boinger/sauna-controller-esp32/README.md

# Sauna Controller - ESP32 Firmware

Open-source ESP32 firmware for controlling an electric sauna heater with native Apple HomeKit integration and a REST API for the companion iOS app.

## Features

- **HomeKit Native**: Appears as a Thermostat in Apple Home app — control via Siri or Home app
- **REST API**: HTTP endpoints for the companion iOS app (port 8080)
- **Temperature Monitoring**: Real-time temperature from DS18B20 sensor
- **Safety First**: Hard temperature limits, session timeouts, fail-safe defaults
- **Local Only**: No cloud, no accounts, no subscriptions — just your local WiFi

## Hardware Requirements

- ESP32 development board (ESP32-WROOM-32 or similar)
- DS18B20 temperature sensor (waterproof version recommended for sauna environment)
- Relay module (5V, appropriate for your contactor coil)
- Contactor rated for your heater (7kW @ 240V = ~30A)

### Wiring

```
ESP32 GPIO 26 ──► Relay IN ──► Contactor Coil
ESP32 GPIO 27 ──► DS18B20 Data (with 4.7kΩ pullup to 3.3V)
ESP32 GPIO 2  ──► Status LED (onboard)
ESP32 3.3V    ──► DS18B20 VCC
ESP32 GND     ──► DS18B20 GND, Relay GND
```

⚠️ **WARNING**: This project controls high-voltage equipment. Ensure all electrical work is done by a qualified electrician and meets local codes.

See the `hardware/` subdirectory for detailed component specs and a KiCad schematic.

## Building

Requires [PlatformIO](https://platformio.org/).

```bash
# Clone the repo
git clone https://github.com/boinger/sauna-controller-esp32.git
cd sauna-controller-esp32

# Build
pio run

# Flash to ESP32
pio run --target upload

# Monitor serial output
pio device monitor
```

## OTA Updates

After the initial USB flash, firmware can be updated over WiFi (OTA):

```bash
pio run --target upload --upload-port <ESP32_IP>
```

You'll be prompted for the OTA password (set in `include/secrets.h`).

**First-time setup:**
1. Copy `include/secrets.h.example` to `include/secrets.h`
2. Set your OTA password in `secrets.h`
3. Flash via USB: `pio run --target upload`
4. All subsequent updates can use OTA

The OTA password can also be changed at runtime via the HomeSpan serial CLI (`O` command).

## HomeKit Setup

1. Power on the ESP32
2. Open the Home app on your iPhone
3. Tap "+" → "Add Accessory"
4. The ESP32 will broadcast as "Sauna Controller"
5. Follow pairing prompts (default setup code shown in serial monitor)

## WiFi Configuration

The firmware uses HomeSpan's built-in WiFi provisioning. On first boot (or if the stored network is unavailable), you can configure WiFi via:

- **Serial CLI**: Connect via `pio device monitor` and press `W` to start the WiFi setup wizard
- **AP Mode**: The ESP32 creates a temporary access point — connect to it and follow the captive portal prompts

WiFi credentials are stored in the ESP32's non-volatile storage and persist across reboots.

## REST API

The firmware runs an HTTP server on **port 8080** (HomeSpan uses port 80 for HomeKit). All temperatures are in **degrees Celsius**. The companion iOS app communicates via these endpoints:

```bash
# Get current status
curl http://<ESP32-IP>:8080/status
# → {"current_temp":72.5,"target_temp":80.0,"heating":true,"firmware":"1.0.0"}

# Turn heater on (HEAT mode)
curl -X POST -H "Content-Type: application/json" \
  -d '{"state":1}' http://<ESP32-IP>:8080/heater
# → {"ok":true}

# Turn heater off
curl -X POST -H "Content-Type: application/json" \
  -d '{"state":0}' http://<ESP32-IP>:8080/heater

# Set target temperature (40–100°C)
curl -X POST -H "Content-Type: application/json" \
  -d '{"temperature":85.0}' http://<ESP32-IP>:8080/target
```

Changes made via the REST API are reflected in HomeKit, and vice versa — both interfaces control the same thermostat state.

## Safety Features

- **Max Temperature**: Heater auto-disables at 110°C (configurable)
- **Session Limit**: 60-minute hard timeout (configurable)
- **Sensor Failure**: Heater disables if temperature sensor disconnects
- **Fail-Safe Default**: Heater is OFF on boot and on any error

## Related

- [Sauna Controller iOS App](https://github.com/boinger/sauna-controller-app) — Native iOS companion app for this firmware

## Development

```bash
# Static analysis
pio check -e esp32

# Run unit tests (host-native, no hardware needed)
pio test -e native
```

Before submitting a PR, ensure: `pio run -e esp32` compiles with zero warnings, `pio check -e esp32` reports zero defects, and `pio test -e native` passes. See [CONTRIBUTING.md](CONTRIBUTING.md) for full guidelines.

## License

MIT License — see [LICENSE](LICENSE) for details.

## Contributing

Contributions welcome! Please read [CONTRIBUTING.md](CONTRIBUTING.md) and open an issue first to discuss proposed changes.
