boinger/sauna-controller-esp32/hardware/sauna-controller.kicad_sch

## KiCad design hardware/sauna-controller.kicad_sch (2026-01-16)

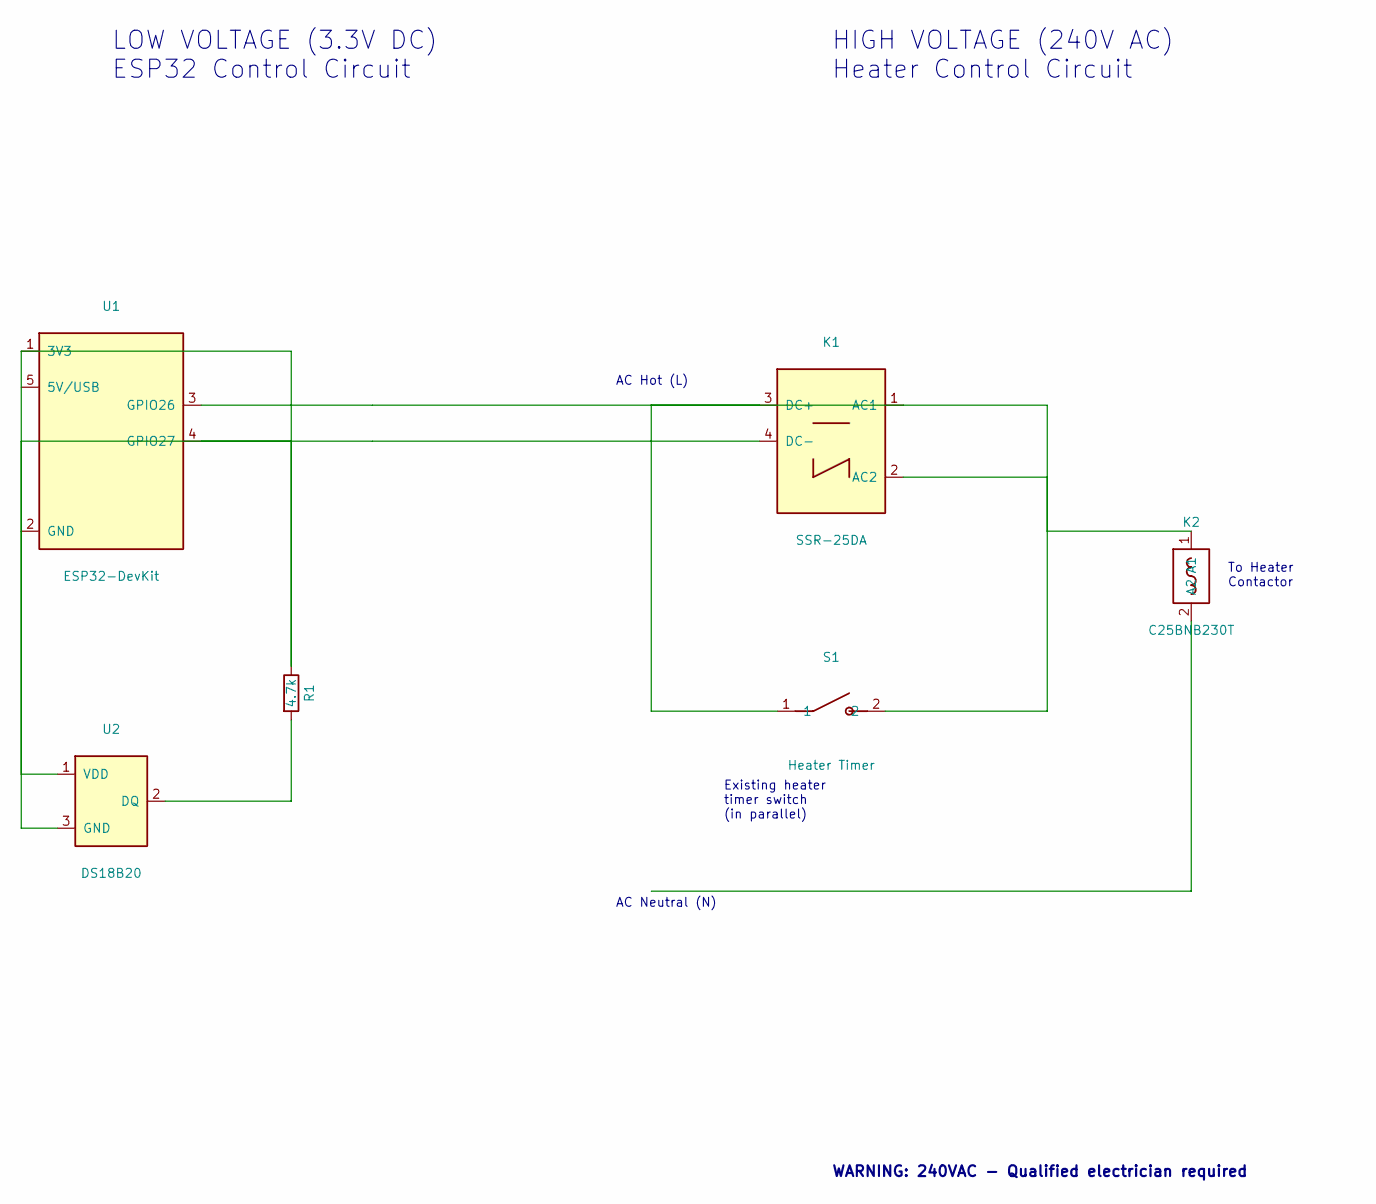
[picture p1: schematic sauna-controller.kicad_sch]

Parts:
K1: SSR-25DA
K2: C25BNB230T
R1: 4.7k
S1: Heater Timer
U1: ESP32-DevKit
U2: DS18B20

Connections:
unnamed: K1.1 (AC1), K1.2 (AC2), K2.1 (A1), S1.1, S1.2
unnamed: K1.3 (DC+), U1.3 (GPIO26)
unnamed: K1.4 (DC-), U1.2 (GND), U2.3 (GND)
unnamed: R1.1, U1.1 (3V3), U1.4 (GPIO27), U2.1 (VDD)
unnamed: R1.2, U2.2 (DQ)

Notes on the sheet:
LOW VOLTAGE (3.3V DC) ESP32 Control Circuit
HIGH VOLTAGE (240V AC) Heater Control Circuit
WARNING: 240VAC - Qualified electrician required
AC Hot (L)
AC Neutral (N)
To Heater Contactor
Existing heater timer switch (in parallel)
