boinger/sauna-controller-esp32/src/main.cpp

/**
 * Sauna Controller - ESP32 Firmware
 *
 * Controls a sauna heater via relay/contactor and monitors temperature
 * using DS18B20 sensor. Exposes HomeKit accessory and REST API for iOS.
 */

#include <Arduino.h>
#include <HomeSpan.h>
#include <OneWire.h>
#include <DallasTemperature.h>
#include <esp_task_wdt.h>
#include <WebServer.h>
#include "sauna_logic.h"
#include "http_validation.h"
#include "secrets.h"

// Compile-time check: our constant must match the DallasTemperature library
static_assert(static_cast<int>(SENSOR_DISCONNECTED_C) == DEVICE_DISCONNECTED_C,
              "SENSOR_DISCONNECTED_C drifted from DEVICE_DISCONNECTED_C");

// =============================================================================
// Version
// =============================================================================
constexpr const char* FIRMWARE_VERSION = "1.0.0";

// =============================================================================
// Pin Definitions
// =============================================================================
constexpr uint8_t PIN_RELAY = 26;           // Relay output to contactor
constexpr uint8_t PIN_TEMP_SENSOR = 27;     // DS18B20 data pin
constexpr uint8_t PIN_STATUS_LED = 2;       // Onboard LED for status

// =============================================================================
// Hardware Timing (not testable logic — stays here)
// =============================================================================
constexpr uint32_t TEMP_READ_INTERVAL_MS = 2000;
constexpr uint32_t CONVERSION_WAIT_MS = 750; // DS18B20 12-bit conversion time

// =============================================================================
// Global Objects
// =============================================================================
OneWire oneWire(PIN_TEMP_SENSOR);
DallasTemperature tempSensor(&oneWire);
WebServer httpServer(8080);

// Forward declaration — full definition below
struct SaunaThermostat;
SaunaThermostat *thermostat = nullptr;  // set in setup(), used by HTTP handlers

// =============================================================================
// HomeKit Accessory Definitions
// =============================================================================

// Thermostat accessory for sauna control
struct SaunaThermostat : Service::Thermostat {
    SpanCharacteristic *currentTemp;
    SpanCharacteristic *targetTemp;
    SpanCharacteristic *currentState;
    SpanCharacteristic *targetState;

    bool heaterActive = false;
    bool sensorFault = false;
    uint32_t sessionStartTime = 0;
    bool conversionRequested = false;
    uint32_t lastConversionRequest = 0;

    SaunaThermostat() : Service::Thermostat() {
        currentTemp = new Characteristic::CurrentTemperature(20.0);
        currentTemp->setRange(0, 120);

        targetTemp = new Characteristic::TargetTemperature(70.0);
        targetTemp->setRange(40, 100);

        currentState = new Characteristic::CurrentHeatingCoolingState(0);
        targetState = new Characteristic::TargetHeatingCoolingState(0);

        new Characteristic::TemperatureDisplayUnits(0);  // Celsius

        // Sauna only heats, no cooling
        targetState->setValidValues(2, 0, 1);  // OFF and HEAT only
    }

    bool update() override {
        if (targetState->updated()) {
            int oldState = targetState->getVal();
            int state = targetState->getNewVal();

            if (state == 1 && !canAcceptHeatCommand(sensorFault)) {
                LOG1("SAFETY: HEAT command blocked — sensor fault active\n");
                return false;
            }

            if (state == 0) {
                setHeaterState(false);
            } else if (state == 1 && oldState != 1) {
                startSession();
            }
            // state == 1 (HEAT): don't turn heater on immediately.
            // loop() will engage it when temperature is below target.
            LOG1("HomeKit: Target state set to %s\n", state == 1 ? "HEAT" : "OFF");
        }

        if (targetTemp->updated()) {
            float target = targetTemp->getNewVal<float>();
            LOG1("HomeKit: Target temp set to %.1f°C\n", target);
        }

        return true;
    }

    void loop() override {
        uint32_t now = millis();

        // --- Session timeout safety check ---
        if (targetState->getVal() == 1 && isSessionExpired(sessionStartTime, now)) {
            setHeaterState(false);
            targetState->setVal(0);
            LOG1("SAFETY: Session time limit (%u min) reached, heater disabled\n",
                 SESSION_MAX_MINUTES);
        }

        // --- Async temperature read state machine ---
        if (!conversionRequested) {
            // Phase 1: Request a new conversion at the configured interval
            if (now - lastConversionRequest >= TEMP_READ_INTERVAL_MS) {
                tempSensor.requestTemperatures();
                conversionRequested = true;
                lastConversionRequest = now;
            }
        } else {
            // Phase 2: Wait for conversion to complete, then process
            if (now - lastConversionRequest >= CONVERSION_WAIT_MS) {
                conversionRequested = false;
                float temp = tempSensor.getTempCByIndex(0);

                if (isSensorFault(temp)) {
                    // Sensor fault — fail safe immediately
                    LOG1("SAFETY: Temperature sensor fault (%.1f), heater disabled\n", temp);
                    setHeaterState(false);
                    targetState->setVal(0);
                    sensorFault = true;
                    currentState->setVal(0);
                } else {
                    // Valid reading
                    sensorFault = false;
                    currentTemp->setVal(temp);

                    if (isOverTemperature(temp)) {
                        setHeaterState(false);
                        targetState->setVal(0);
                        LOG1("SAFETY: Max temp (%.0f°C) reached, heater disabled\n",
                             TEMP_MAX_CELSIUS);
                    }
                    else if (targetState->getVal() == 1) {
                        float target = targetTemp->getVal<float>();
                        bool desired = shouldHeaterEngage(temp, target, heaterActive);
                        if (desired != heaterActive) {
                            setHeaterState(desired);
                        }
                    }

                    currentState->setVal(heaterActive ? 1 : 0);
                }
            }
        }
    }

    void startSession() {
        sessionStartTime = millis();
    }

    void setHeaterState(bool on) {
        heaterActive = on;
        digitalWrite(PIN_RELAY, on ? HIGH : LOW);
        digitalWrite(PIN_STATUS_LED, on ? HIGH : LOW);
    }
};

// =============================================================================
// REST API Handlers (port 8080)
// =============================================================================

void handleGetStatus() {
    char json[128];
    snprintf(json, sizeof(json),
        "{\"current_temp\":%.1f,\"target_temp\":%.1f,\"heating\":%s,\"firmware\":\"%s\"}",
        thermostat->currentTemp->getVal<float>(),
        thermostat->targetTemp->getVal<float>(),
        thermostat->heaterActive ? "true" : "false",
        FIRMWARE_VERSION);
    httpServer.send(200, "application/json", json);
}

void handlePostHeater() {
    if (httpServer.header("Content-Type").indexOf("application/json") < 0) {
        httpServer.send(415, "application/json",
            "{\"error\":\"Content-Type must be application/json\"}");
        return;
    }

    String body = httpServer.arg("plain");

    // Parse "state" from JSON body (manual — avoids ArduinoJson dep)
    int idx = body.indexOf("\"state\"");
    if (idx < 0) {
        httpServer.send(400, "application/json", "{\"error\":\"missing 'state' field\"}");
        return;
    }
    int colon = body.indexOf(':', idx);
    if (colon < 0) {
        httpServer.send(400, "application/json", "{\"error\":\"malformed JSON\"}");
        return;
    }

    int state;
    if (!parseIntValue(body.substring(colon + 1).c_str(), state)) {
        httpServer.send(400, "application/json", "{\"error\":\"invalid state, must be 0 or 1\"}");
        return;
    }

    if (!isValidHeaterState(state)) {
        httpServer.send(400, "application/json", "{\"error\":\"invalid state, must be 0 or 1\"}");
        return;
    }

    if (state == 1 && !canAcceptHeatCommand(thermostat->sensorFault)) {
        httpServer.send(503, "application/json",
            "{\"error\":\"sensor fault active, cannot enable heater\"}");
        return;
    }

    if (state == 0) {
        thermostat->setHeaterState(false);
        thermostat->targetState->setVal(0);
    } else {
        // Set target state to HEAT — loop() engages relay through safety checks.
        // Never call setHeaterState(true) directly from a command path.
        if (thermostat->targetState->getVal() != 1) {
            thermostat->startSession();
        }
        thermostat->targetState->setVal(1);
    }

    httpServer.send(200, "application/json", "{\"ok\":true}");
}

void handlePostTarget() {
    if (httpServer.header("Content-Type").indexOf("application/json") < 0) {
        httpServer.send(415, "application/json",
            "{\"error\":\"Content-Type must be application/json\"}");
        return;
    }

    String body = httpServer.arg("plain");

    // Parse "temperature" from JSON body
    int idx = body.indexOf("\"temperature\"");
    if (idx < 0) {
        httpServer.send(400, "application/json", "{\"error\":\"missing 'temperature' field\"}");
        return;
    }
    int colon = body.indexOf(':', idx);
    if (colon < 0) {
        httpServer.send(400, "application/json", "{\"error\":\"malformed JSON\"}");
        return;
    }

    float temperature;
    if (!parseFloatValue(body.substring(colon + 1).c_str(), temperature)) {
        httpServer.send(400, "application/json", "{\"error\":\"invalid temperature value\"}");
        return;
    }

    if (!isValidTargetTemp(temperature)) {
        char err[80];
        snprintf(err, sizeof(err),
            "{\"error\":\"temperature must be between %.0f and %.0f\"}",
            TARGET_TEMP_MIN, TARGET_TEMP_MAX);
        httpServer.send(400, "application/json", err);
        return;
    }

    thermostat->targetTemp->setVal(temperature);
    httpServer.send(200, "application/json", "{\"ok\":true}");
}

// =============================================================================
// HTTP Server Startup (called by HomeSpan once WiFi connects)
// =============================================================================

void startHttpServer() {
    httpServer.on("/status", HTTP_GET, handleGetStatus);
    httpServer.on("/heater", HTTP_POST, handlePostHeater);
    httpServer.on("/target", HTTP_POST, handlePostTarget);
    const char* headerKeys[] = {"Content-Type"};
    httpServer.collectHeaders(headerKeys, 1);
    httpServer.begin();
    Serial.println("REST API listening on port 8080.");
}

// =============================================================================
// Setup & Loop
// =============================================================================

void setup() {
    Serial.begin(115200);
    delay(1000);

    Serial.println("\n=================================");
    Serial.println("  Sauna Controller Starting...");
    Serial.println("=================================\n");

    // Initialize pins — heater OFF by default
    pinMode(PIN_RELAY, OUTPUT);
    pinMode(PIN_STATUS_LED, OUTPUT);
    digitalWrite(PIN_RELAY, LOW);

    // Initialize temperature sensor
    tempSensor.begin();
    int sensorCount = tempSensor.getDeviceCount();
    Serial.printf("Found %d temperature sensor(s)\n", sensorCount);

    if (sensorCount == 0) {
        Serial.println("FATAL: No temperature sensor found — halting.");
        Serial.println("Check wiring on GPIO 27 and reset the device.");
        while (true) {
            digitalWrite(PIN_STATUS_LED, !digitalRead(PIN_STATUS_LED));
            delay(250);
        }
    }

    tempSensor.setWaitForConversion(false);  // Non-blocking reads

    // Initialize HomeSpan — start HTTP server once WiFi connects
    homeSpan.setWifiCallback(startHttpServer);
    homeSpan.enableOTA(OTA_PASSWORD);
    homeSpan.begin(Category::Thermostats, "Sauna Controller");

    // Create the accessory
    new SpanAccessory();
        new Service::AccessoryInformation();
            new Characteristic::Identify();
            new Characteristic::Name("Sauna");
            new Characteristic::Manufacturer("DIY");
            new Characteristic::Model("SaunaController-v1");
            new Characteristic::SerialNumber("001");
            new Characteristic::FirmwareRevision(FIRMWARE_VERSION);
        thermostat = new SaunaThermostat();

    Serial.println("\nHomeKit accessory ready.");
    Serial.println("Use the Home app to pair this device.\n");

    // Hardware watchdog — resets ESP32 if loop() stalls for 30s
    esp_task_wdt_init(30, true);
    esp_task_wdt_add(NULL);
}

void loop() {
    esp_task_wdt_reset();
    homeSpan.poll();
    httpServer.handleClient();
}
