boinger/sauna-controller-esp32/(commit log)

2026-01-15 Initial commit: ESP32 sauna controller firmware
    - PlatformIO project targeting ESP32 with Arduino framework
    - HomeSpan library for native HomeKit integration (Thermostat service)
    - DS18B20 temperature sensor support via OneWire/DallasTemperature
    - Relay control for heater contactor
    - Safety limits: max temp 110°C, session timeout 60min
    - Fail-safe defaults (heater OFF on boot/error)
    [main.cpp]
2026-01-16 Add KiCad schematic for hardware wiring
    - ESP32 module with GPIO26 (SSR) and GPIO27 (temp sensor)
    - DS18B20 temperature sensor with 4.7k pull-up
    - SSR-25DA solid state relay for contactor control
    - Parallel wiring with existing heater timer
    - Hardware README with wiring summary and safety notes
    [sauna-controller.kicad_sch]
2026-02-07 Fix critical safety gaps and implement thermostat control logic
    The thermostat had no temperature control — it heated to the 110C safety
    limit regardless of target. Worse, sensor disconnect left the heater ON
    indefinitely. This adds the missing safety systems and real thermostat
    behavior:
    - Sensor disconnect/fault immediately kills heater and blocks HEAT commands
    - Boot without sensor halts startup with LED blink (never inits HomeKit)
    - Bang-bang thermostat with 2C hysteresis (ON at target-2, OFF at target)
    - 60-minute session timeout auto-shutoff
    - 30-second hardware watchdog resets ESP32 if loop() stalls
    - Async DS18B20 reads eliminate 750ms blocking that froze HomeKit
    - Software heater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
    [main.cpp]
2026-02-07 Add linting, unit tests, and extract safety logic into testable functions
    Extract 5 pure safety-decision functions (sensor fault detection,
    over-temperature cutoff, session timeout, thermostat hysteresis,
    heat command gating) from SaunaThermostat into include/sauna_logic.h
    with zero hardware dependencies.
    Add 24 Unity tests covering all boundary conditions including
    millis() wraparound, hysteresis deadband edges, and sensor
    disconnect values. Configure cppcheck static analysis and
    PlatformIO native test environment for host-side execution.
2026-02-20 Add REST API server on port 8080 for iOS app communication
    Three endpoints: GET /status, POST /heater, POST /target — matching
    the contract the iOS app already expects. HomeSpan occupies port 80
    for HAP, so the REST API runs on 8080.
    Safety invariant preserved: POST /heater with state=1 sets targetState
    to HEAT and lets loop() engage the relay through the full safety
    pipeline (sensor fault, over-temp, session timeout). Only state=0
    directly disables the heater.
    Input validation extracted to http_validation.h (pure functions,
    tested natively) to keep sauna_logic.h untouched.
2026-02-20 Add system specification and feature roadmap
    SPEC.md documents the full interface contract between firmware and iOS
    app: REST API schemas, HomeKit characteristics, safety model, state
    ownership, shared constants, and known gaps.
    ROADMAP.md prioritizes features across three tiers, from required-for-
    first-use (sensor fault visibility, session timeout) through future
    enhancements (scheduling, WebSocket push, Watch app).
2026-02-20 Add community docs, CI workflow, and README improvements
    Add missing LICENSE (MIT), CONTRIBUTING.md, SECURITY.md, CHANGELOG.md,
    CODE_OF_CONDUCT.md (Contributor Covenant v2.1), and .gitattributes.
    Add GitHub Actions CI workflow (build, static analysis, unit tests),
    issue templates (bug report, feature request), and PR template.
    README updates: WiFi configuration section, GPIO 2 status LED in wiring
    diagram, hardware/ subdirectory reference, Celsius units clarified in
    REST API section, Development section with test/lint commands.
2026-02-21 Update docs to reflect app hardcoded port 8080
    The iOS app now hardcodes :8080 in the base URL (commit 10ceec7 in
    the app repo), so users enter only the bare IP address. Update three
    references in SPEC.md (§4.1, §6, §8.3) and the mDNS roadmap item
    in ROADMAP.md to match current behavior.
2026-02-21 Update espressif32 6.3.2 → 6.12.0 and DallasTemperature 3.11.0 → 4.0.6
    espressif32 6.12.0 brings security and stability patches while remaining
    on Arduino-ESP32 2.x. DallasTemperature 4.x is a major version bump but
    backward-compatible for our usage (requestTemperatures() return type
    changed from void to request_t, which we discard). OneWire and HomeSpan
    remain at current versions.
2026-02-22 Fix session timer reset on heater cycling and reject non-numeric API input
    Session timer: sessionStartTime was reset every time setHeaterState(true)
    was called, which happens on each hysteresis cycle. A sauna cycling around
    its target could run indefinitely, defeating the 60-minute safety limit.
    Now the timer starts only on OFF→HEAT transitions (in both HomeKit and REST
    paths), and the timeout check runs whenever targetState==1 regardless of
    relay state.
    Input parsing: Arduino's toInt()/toFloat() return 0 for garbage strings,
    silently accepting invalid input as state=0. Added strict parsers using
    strtol/strtof that reject non-numeric values with a 400 error. Also added
    setUp/tearDown stub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
    [http_validation.h, main.cpp]
2026-02-22 Defer HTTP server startup until WiFi is connected
    httpServer.begin() in setup() crashed on boot because HomeSpan
    initializes WiFi lazily during poll(). Move route registration
    and server startup into a callback via homeSpan.setWifiCallback()
    so the lwIP stack exists when WebServer binds its socket.
    [main.cpp]
2026-02-22 Add wiring diagram for sauna controller circuit
2026-03-24 Harden safety checks and enforce strict compiler warnings
    Add NaN/Inf guard to isSensorFault() and isOverTemperature() — IEEE 754
    NaN bypasses comparison operators, which could keep the heater ON. Add
    Content-Type validation to POST handlers. Enable -Wall -Wextra -Werror
    via build_src_flags for project source (libraries excluded).
2026-03-24 Update espressif32 platform 6.12.0 → 6.13.0
2026-03-24 Enable OTA firmware updates via HomeSpan
    Add homeSpan.enableOTA() with password from gitignored secrets.h.
    Pin partition scheme to default.csv to prevent drift. Add OTA upload
    config (commented out) to platformio.ini. Include secrets.h.example
    template for new clones.
    [main.cpp]
